kingovchouffe/HM2/Meca/dc jack.dxf

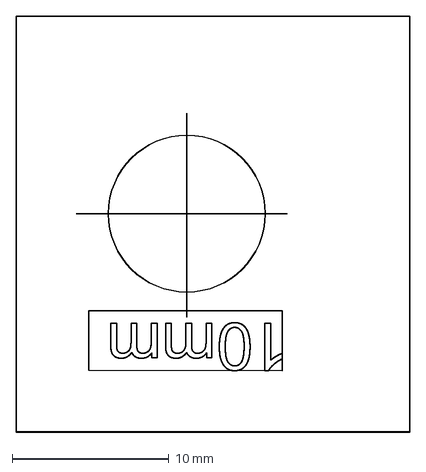
[picture p1: CAD file, 2024-09-27]
Meca/dc jack.dxf
25.1 x 26.5 mm
