kingovchouffe/HM2/Meca/coté_gauche.dxf

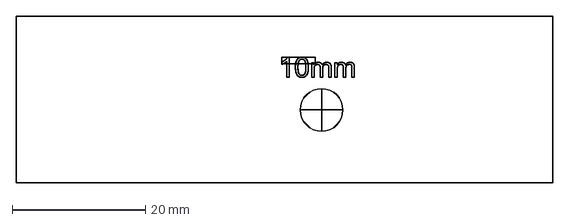
[picture p2: CAD file, 2024-09-27]
Meca/coté_gauche.dxf
80.6 x 25.1 mm
