kingovchouffe/HM2/Meca/plan de coupe top.dxf

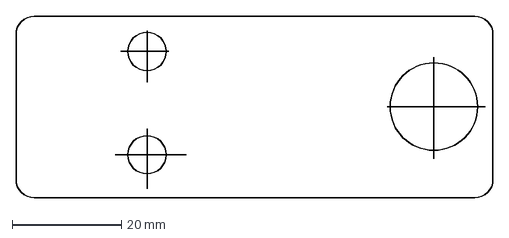
[picture p3: CAD file, 2024-09-27]
Meca/plan de coupe top.dxf
87.3 x 33.2 mm
