kingovchouffe/HM2/Meca/coté_droit.dxf

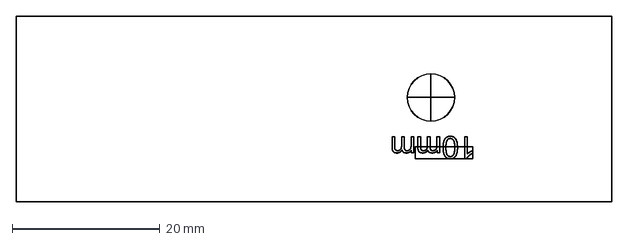
[picture p4: CAD file, 2024-09-27]
Meca/coté_droit.dxf
80.6 x 25.1 mm
