kingovchouffe/HM2/Meca/1590A.stp

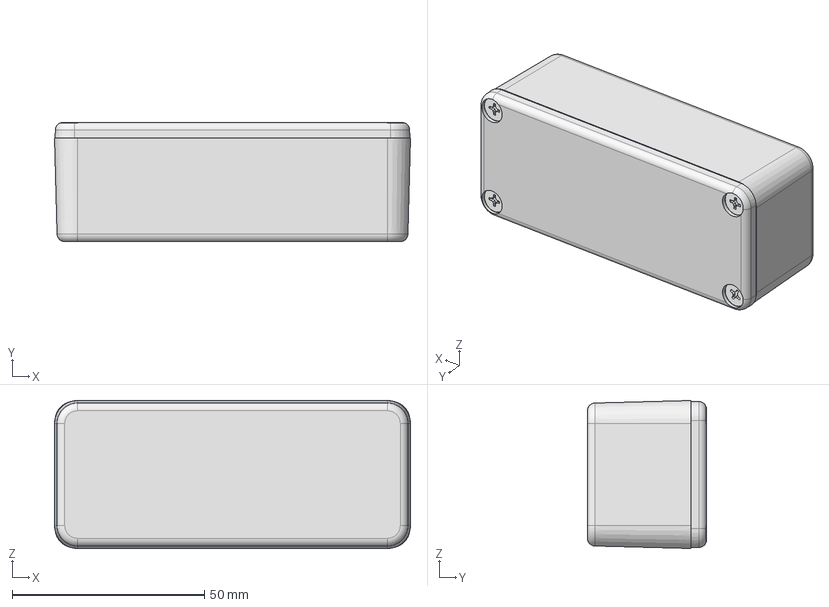
[picture p5: CAD file, 2024-09-03]
Meca/1590A.stp
92.6 x 31.0 x 38.5 mm
