kingovchouffe/HM2/HM2.pdf

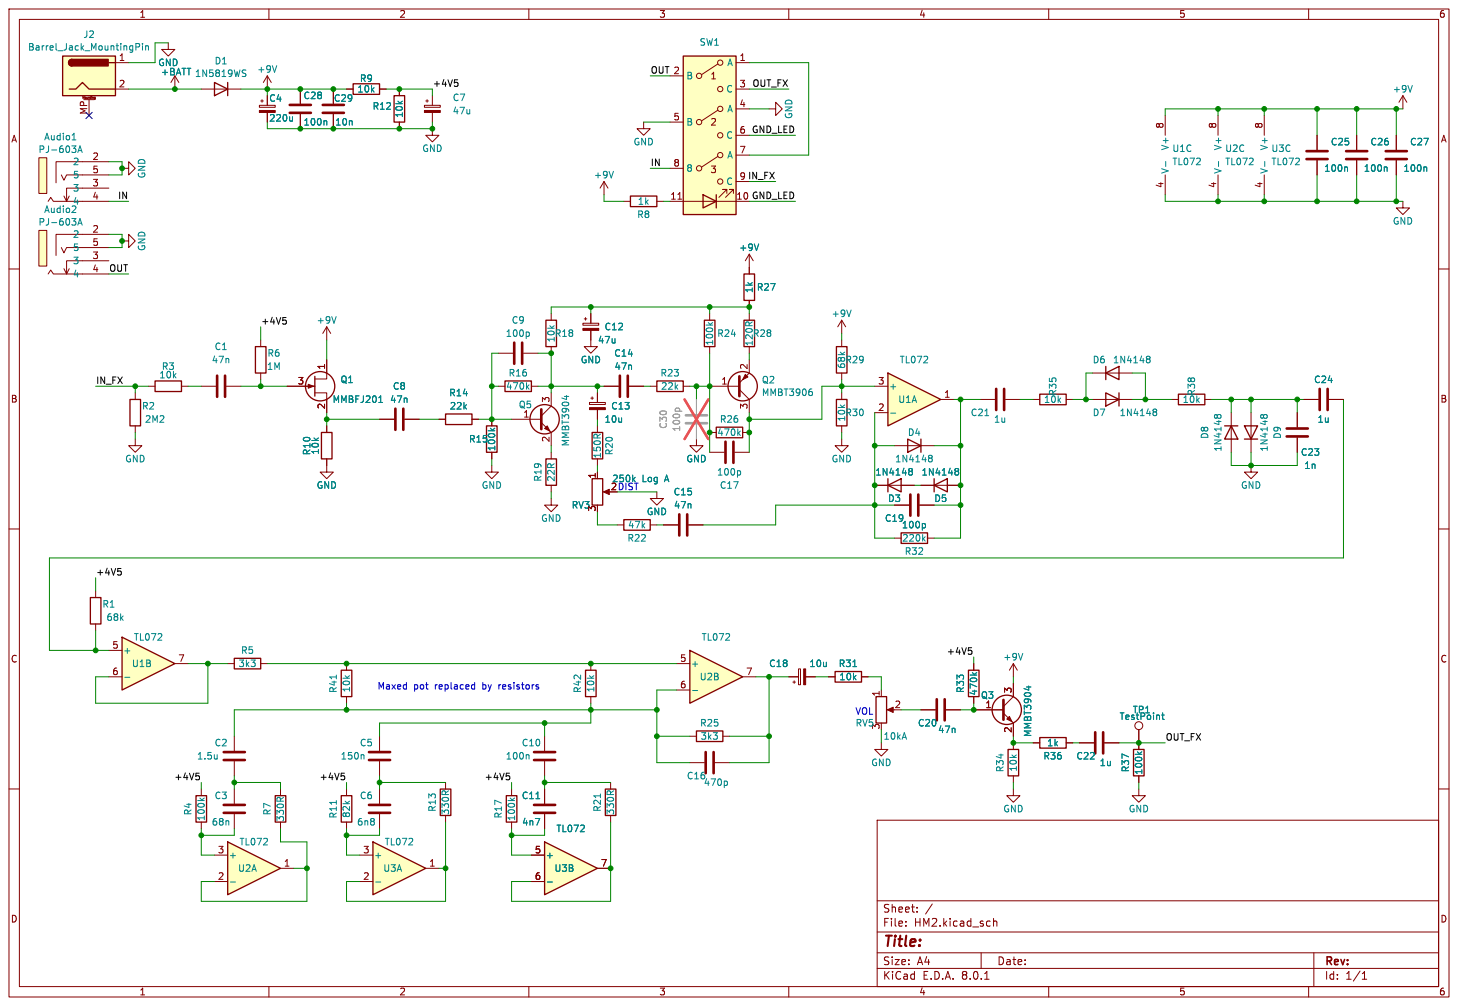
[picture p6: page 1]

Id: 1/1 Title: File: HM2.kicad_sch Sheet: /
