kingovchouffe/HM2/HM2.kicad_pcb

## KiCad design HM2.kicad_pcb (2024-09-27)

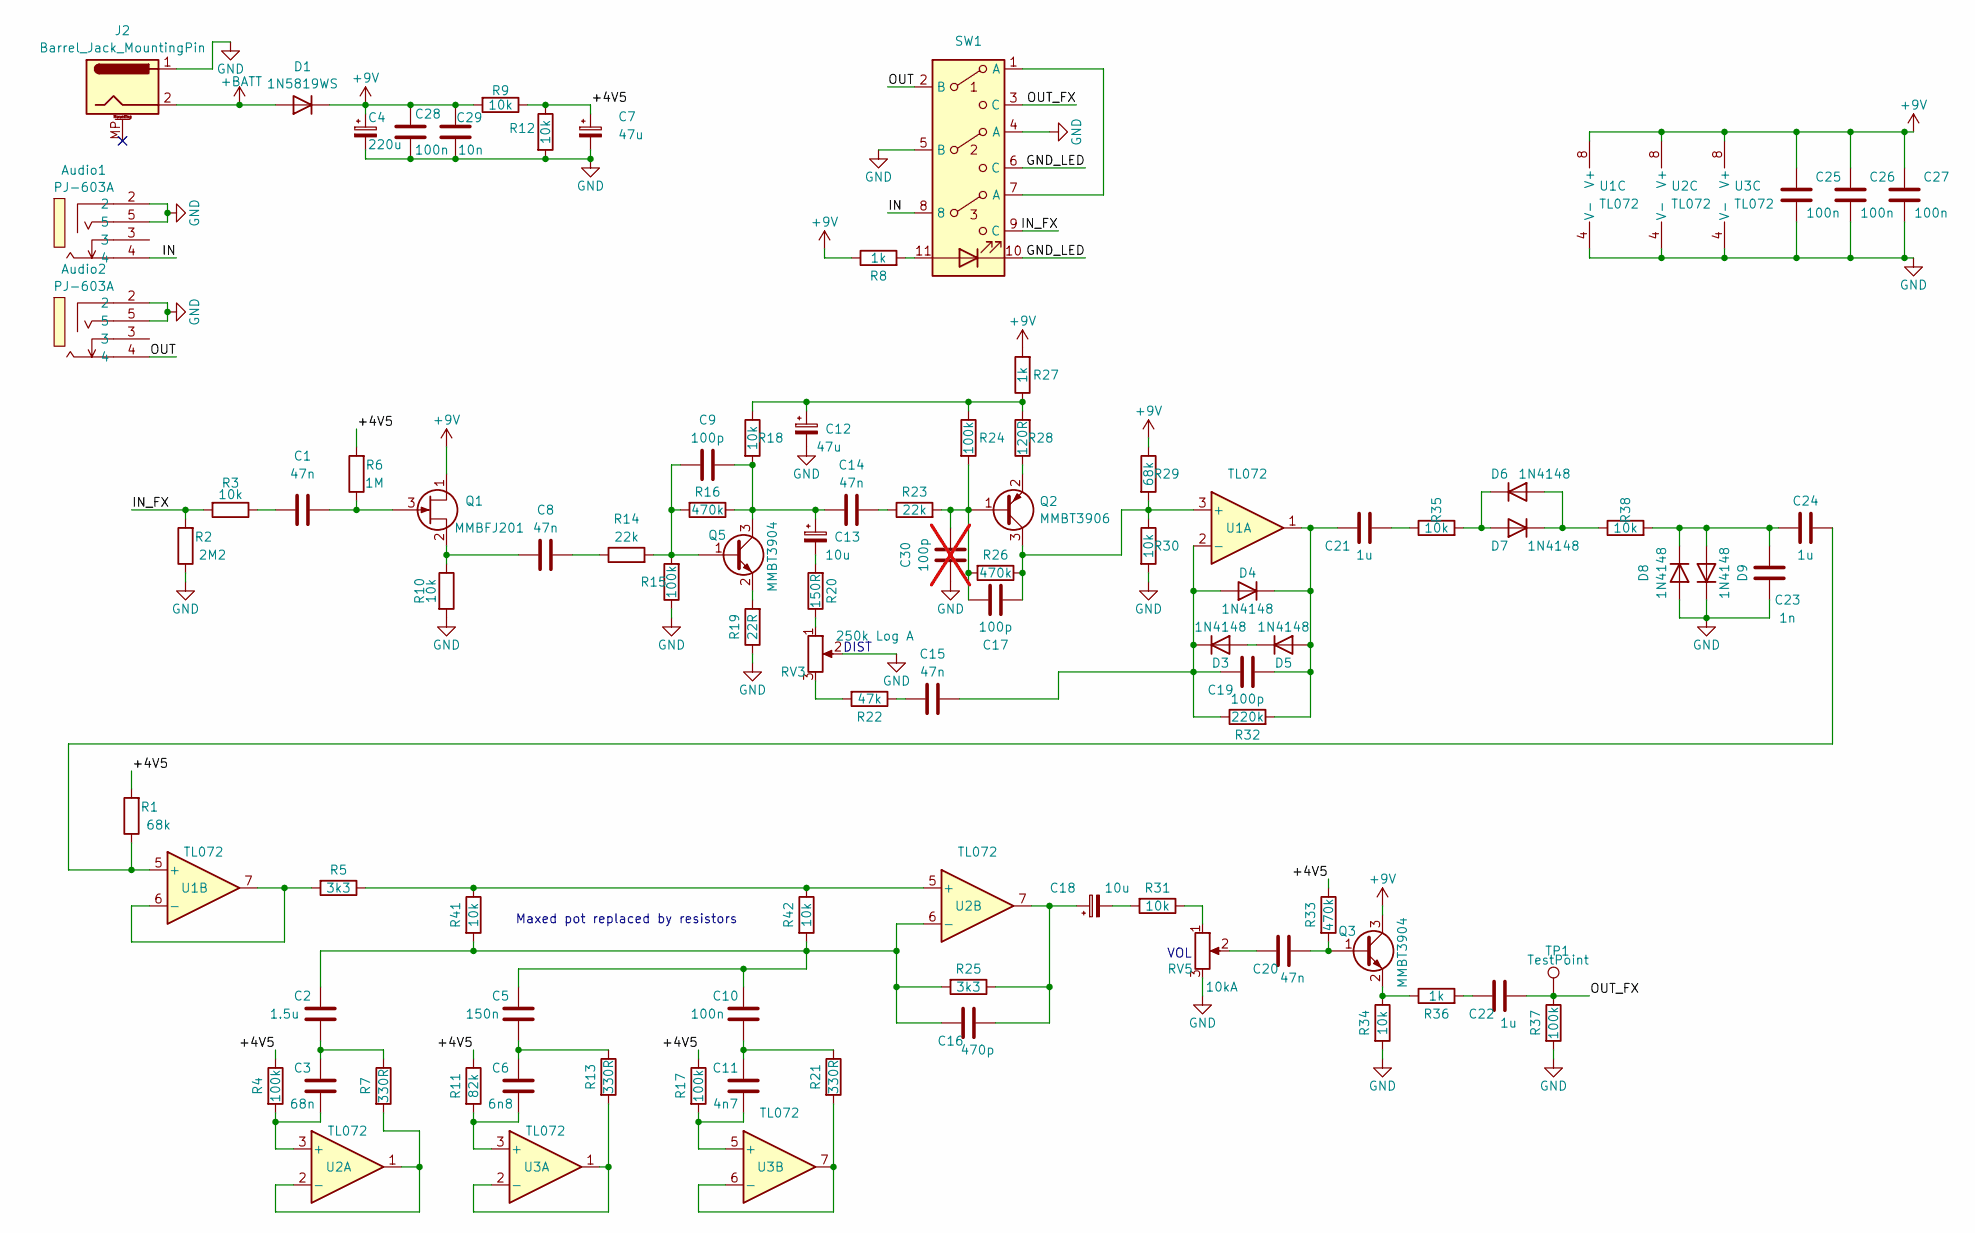
[picture p7: schematic HM2.kicad_sch]

Parts:
Audio1, Audio2: PJ-603A; AUDIO-TH_PJ-603A_1; LCSC Part C309273
C1, C8, C14, C15, C20: 47n; C_0603_1608Metric
C2: 1.5u; C_0805_2012Metric
C3: 68n; C_0603_1608Metric
C4: 220u; CP_Elec_6.3x7.7
C5: 150n; C_0603_1608Metric
C6: 6n8; C_0603_1608Metric
C7: 47u; CP_Elec_6.3x5.8
C9, C17, C19: 100p; C_0603_1608Metric
C10, C25, C26, C27, C28: 100n; C_0603_1608Metric
C11: 4n7; C_0603_1608Metric
C12: 47u; CP_Elec_4x5.8
C13, C18: 10u; CP_Elec_5x5.4
C16: 470p; C_0603_1608Metric
C21, C22, C24: 1u; C_0805_2012Metric
C23: 1n; C_0603_1608Metric
C29: 10n; C_0603_1608Metric
C30: 100p; C_0603_1608Metric; not fitted
D1: 1N5819WS; D_SOD-323
D3, D4, D5, D6, D7, D8, D9: 1N4148; D_SOD-323
J2: Barrel_Jack_MountingPin; BarrelJack_Horizontal
Q1: MMBFJ201; SOT-23-3
Q2: MMBT3906; SOT-23
Q3, Q5: MMBT3904; SOT-23
R1, R29: 68k; R_0603_1608Metric
R2: 2M2; R_0603_1608Metric
R3, R9, R10, R12, R18, R30, R31, R34, R35, R38, R41, R42: 10k; R_0603_1608Metric
R4, R15, R17, R24, R37: 100k; R_0603_1608Metric
R5, R25: 3k3; R_0603_1608Metric
R6: 1M; R_0603_1608Metric
R7, R13, R21: 330R; R_0603_1608Metric
R8, R27, R36: 1k; R_0603_1608Metric
R11: 82k; R_0603_1608Metric
R14, R23: 22k; R_0603_1608Metric
R16, R26, R33: 470k; R_0603_1608Metric
R19: 22R; R_0603_1608Metric
R20: 150R; R_0603_1608Metric
R22: 47k; R_0603_1608Metric
R28: 120R; R_0603_1608Metric
R32: 220k; R_0603_1608Metric
RV3: 250k Log A; Potentiometer_Alpha_RD901F-40-00D_Single_Vertical
RV5: 10kA; Potentiometer_Alpha_RD901F-40-00D_Single_Vertical
SW1: 3PDT_LED
TP1: TestPoint; TestPoint_Pad_D1.5mm
U1, U2, U3: TL072; SOIC-8_3.9x4.9mm_P1.27mm

Connections:
+9V: C4.1, C25.2, C26.2, C27.2, C28.2, C29.2, D1.1 (K), Q1.1 (D), Q3.3 (C), R8.1, R9.2, R27.2, R29.1, U1.8 (V+), U2.8 (V+), U3.8 (V+)
+BATT: D1.2 (A), J2.2
/+4V5: C7.1, R1.2, R4.1, R6.2, R9.1, R11.1, R12.1, R17.1, R33.1
/GND_LED: SW1.6 (C), SW1.10, SW1.12
/IN: Audio1.4, SW1.8
/IN_FX: R2.2, R3.2, SW1.9 (C)
/OUT: Audio2.4, SW1.2 (B)
/OUT_FX: C22.1, R37.1, SW1.3 (C), TP1.1
GND: Audio1.2, Audio1.5, Audio2.2, Audio2.5, C4.2, C7.2, C12.2, C23.2, C25.1, C26.1, C27.1, C28.1, C29.1, C30.2, D8.2 (A), D9.1 (K), J2.1, R2.1, R10.2, R12.2, R15.1, R19.1, R30.2, R34.2, R37.2, RV3.2, RV5.3, SW1.4 (A), SW1.5 (B), U1.4 (V-), U2.4 (V-), U3.4 (V-)
unnamed: C1.1, R3.1
unnamed: C2.1, C3.2, R7.1
unnamed: C5.1, C6.2, R13.1
unnamed: C8.2, R14.1
unnamed: C10.1, C11.2, R21.1
unnamed: C12.1, R18.1, R24.1, R27.1, R28.2
unnamed: C13.2, R20.2
unnamed: C14.2, R23.1
unnamed: C15.1, R22.1
unnamed: C16.1, C18.1, R25.1, U2.7
unnamed: C18.2, R31.2
unnamed: C20.2, RV5.2
unnamed: C21.1, R35.1
unnamed: C22.2, R36.2
unnamed: D3.2 (A), D5.1 (K)
unnamed: C15.2, C19.2, D3.1 (K), D4.2 (A), R32.1, U1.2 (-)
unnamed: C19.1, C21.2, D4.1 (K), D5.2 (A), R32.2, U1.1
unnamed: D6.2 (A), D7.1 (K), R38.1
unnamed: D6.1 (K), D7.2 (A), R35.2
unnamed: C23.1, C24.2, D8.1 (K), D9.2 (A), R38.2
unnamed: C1.2, Q1.3 (G), R6.1
unnamed: C8.1, Q1.2 (S), R10.1
unnamed: C17.2, C30.1, Q2.1 (B), R23.2, R24.2, R26.2
unnamed: C17.1, Q2.3 (C), R26.1, R29.2, R30.1, U1.3 (+)
unnamed: Q2.2 (E), R28.1
unnamed: C9.1, Q5.1 (B), R14.2, R15.2, R16.2
unnamed: C9.2, C13.1, C14.1, Q5.3 (C), R16.1, R18.2
unnamed: Q5.2 (E), R19.2
unnamed: R8.2, SW1.11
unnamed: R20.1, RV3.1
unnamed: R22.2, RV3.3
unnamed: R31.1, RV5.1
unnamed: SW1.1 (A), SW1.7 (A)
unnamed: C24.1, R1.1, U1.5 (+)
unnamed: R5.2, U1.6 (-), U1.7
unnamed: C3.1, R4.2, U2.3 (+)
unnamed: R7.2, U2.1, U2.2 (-)
unnamed: R5.1, R41.1, R42.1, U2.5 (+)
unnamed: C2.2, C5.2, C10.2, C16.2, R25.2, R41.2, R42.2, U2.6 (-)
unnamed: C6.1, R11.2, U3.3 (+)
unnamed: R13.2, U3.1, U3.2 (-)
unnamed: C11.1, R17.2, U3.5 (+)
unnamed: R21.2, U3.6 (-), U3.7

Notes on the sheet:
VOL
DIST
Maxed pot replaced by resistors

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
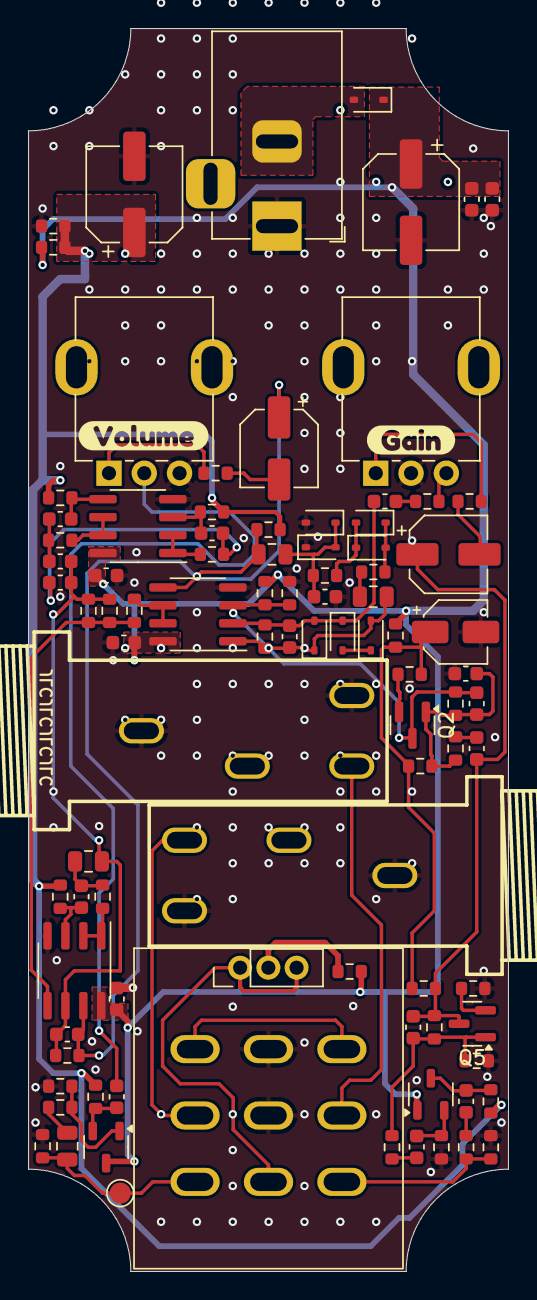
[picture p8: board HM2.kicad_pcb from above]

Board: 2 copper layers, 34.0 x 88.0 mm, 95 parts (0 on the bottom side), 54 nets.

Other parts of the board:
kibuzzard-66E8676F: G***; kibuzzard-66E8676F
kibuzzard-66E8688E: G***; kibuzzard-66E8688E
kibuzzard-66E86754: G***; kibuzzard-66E86754
