kingovchouffe/HM2/(commit log)

2022-08-13 pcb routed
    [HM2.kicad_pcb, HM2.kicad_sch]
2022-08-13 PCB send to prod
    [HM2-CuBottom.gbr, HM2-CuTop.gbr, HM2-EdgeCuts.gbr, HM2-MaskBottom.gbr, HM2-MaskTop.gbr, HM2-NPTH.drl, HM2-PTH.drl, HM2-PasteBottom.gbr]
2022-09-27 Schematic revision add decoupling cap on opamp
    [HM2.kicad_pcb, HM2.kicad_sch]
2024-09-03 v3 to production
    [1590A.stp, HM2.kicad_pcb, HM2.kicad_sch]
2024-09-08 V5 layout to review
    [HM2.kicad_pcb, HM2.kicad_sch]
2024-09-27 Added mecanical drawing and new pdf schem
    v5 working
    [HM2-rounded.kicad_pcb, HM2.kicad_pcb, HM2.kicad_sch, coté_droit.dxf, coté_gauche.dxf, dc jack.dxf, plan de coupe top.dxf]
2024-09-27 cleaning repos
    [1590A.stp, HM2-rounded.kicad_pcb]
2025-03-30 add art for the enclosure
